ohyunsik-cmd/BMS/BMS_extra_file/발표 자료/미팅발표자료_2.19_BMS.pptx

## 2월 19일 BMS 발표

이준영, 이한준, 오윤식

## PCB 레이아웃

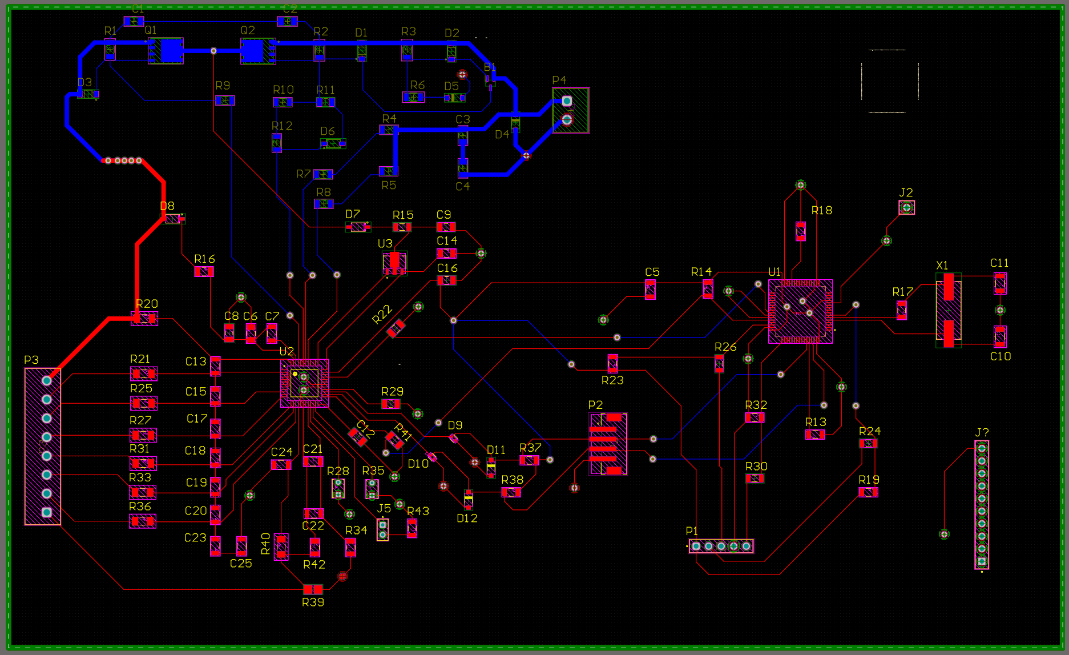
[picture p63: figure]

## PCB 레이아웃(1)

대전류가 흐르는 부분은 PCB의 뒷면에 배치하였음.

대전류가 흐르는 부분은 wire의 두께를 두껍게 설정(=40mil)

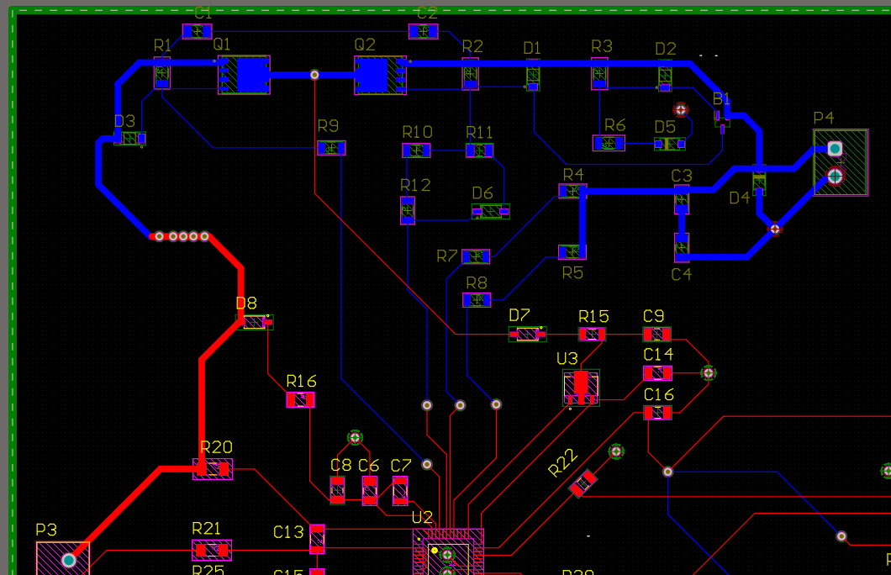
[picture p64: figure]

PGND는 layer 3층에 Net설정으로 지정하였음.

## PCB 레이아웃(2)

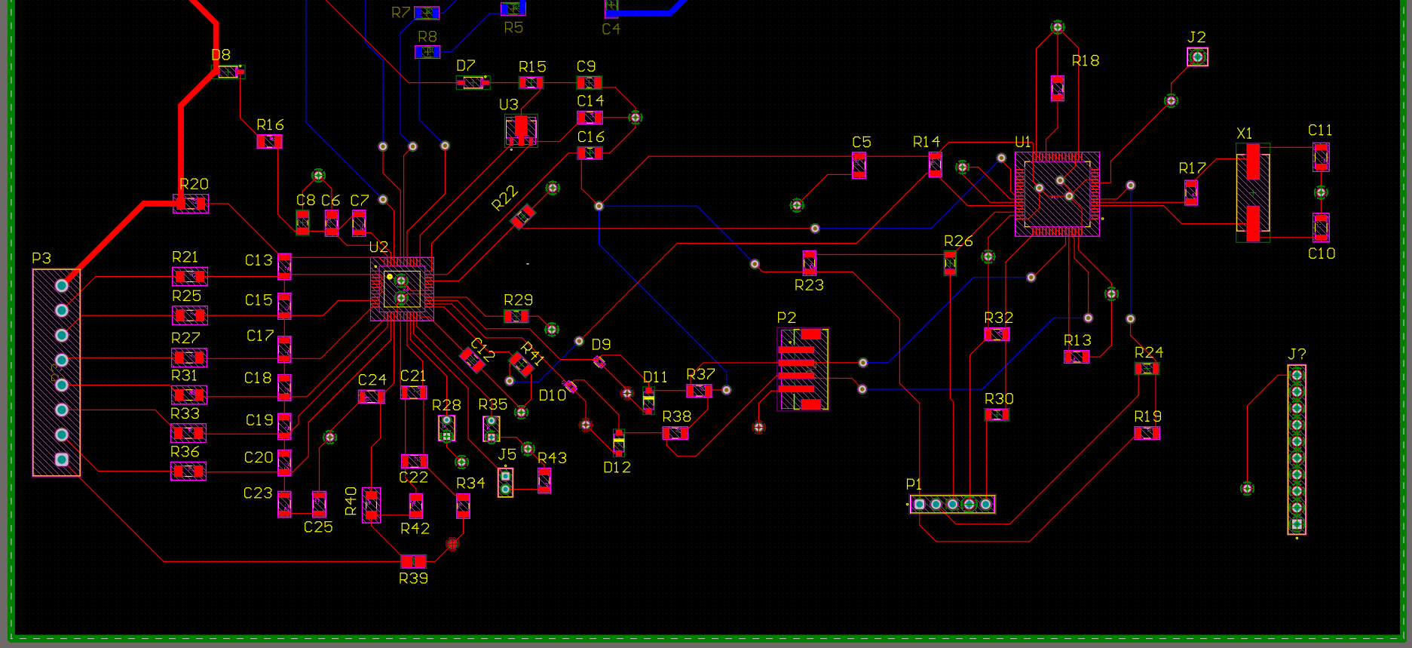
[picture p65: figure]

MCU 부분 배치

IC 부분 배치

## 원래 회로에서 소자 변경된 점

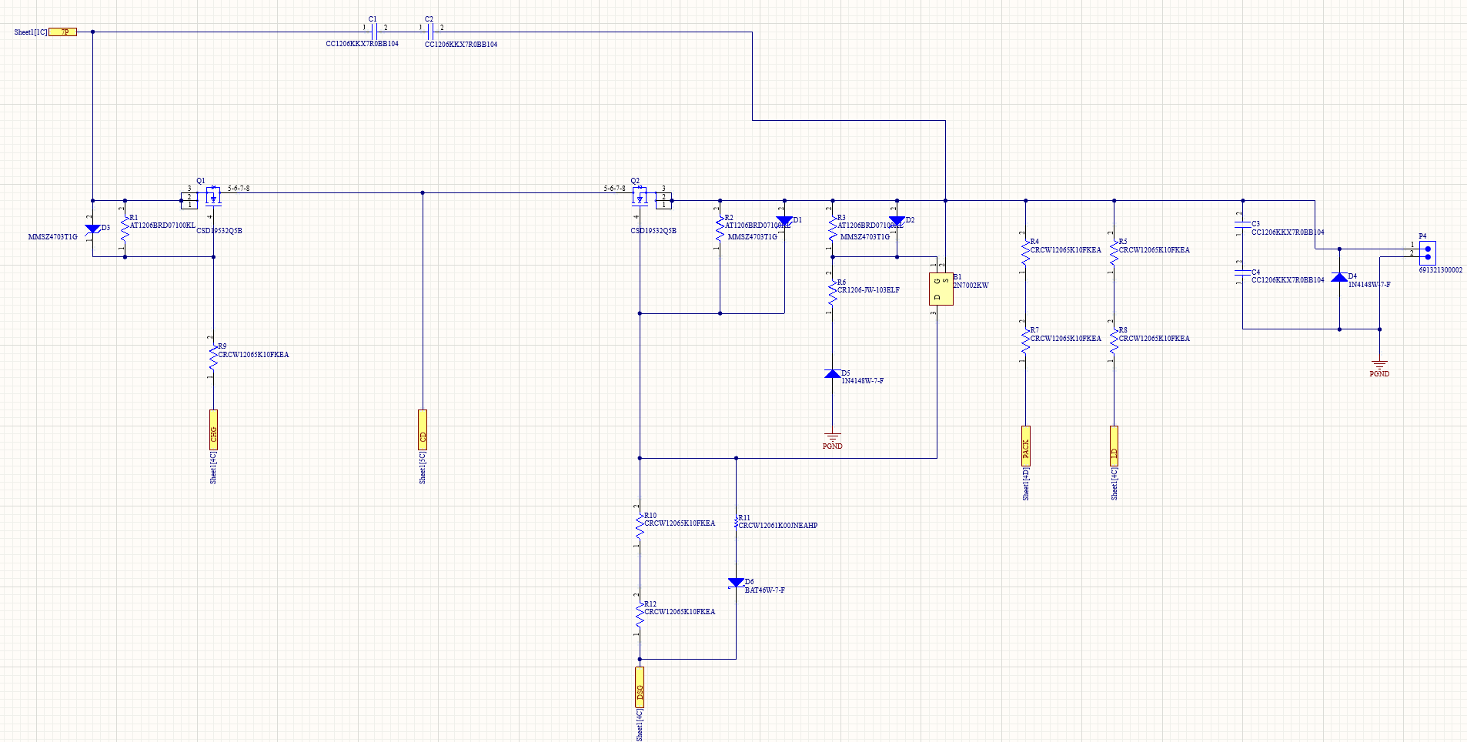
[picture p66: figure]

원래 데이터시트는
MMSZ5246B-7-F를 사용
구글링 해도 나오지 않음.
MMSZ4703T1G으로 회로 구성

## 소자 비교

MMSZ4703T1G

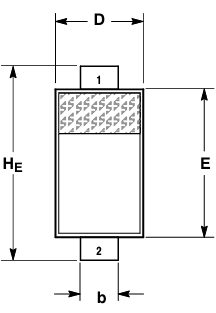
[picture p67: figure]

MMSZ5246B-7-F

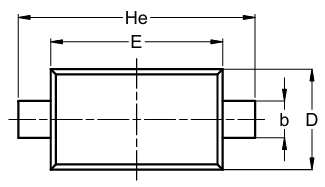
[picture p68: figure]

우측 소자의 footprint 및 symbol을 찾을 수 없어서 크기가 같고 성능이 동일한 소자를 찾아서 schematic에 추가

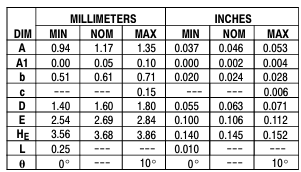
[picture p69: figure]
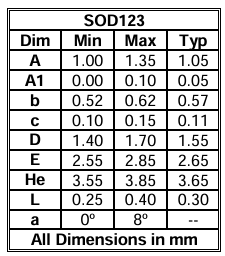
[picture p70: figure]

## 소자 주문

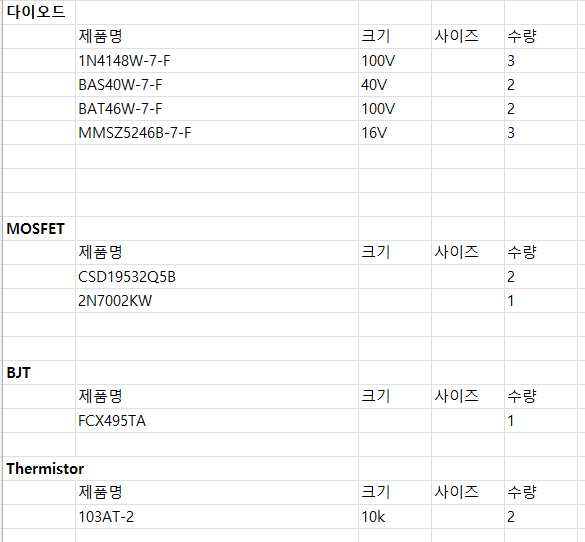
[picture p71: figure]
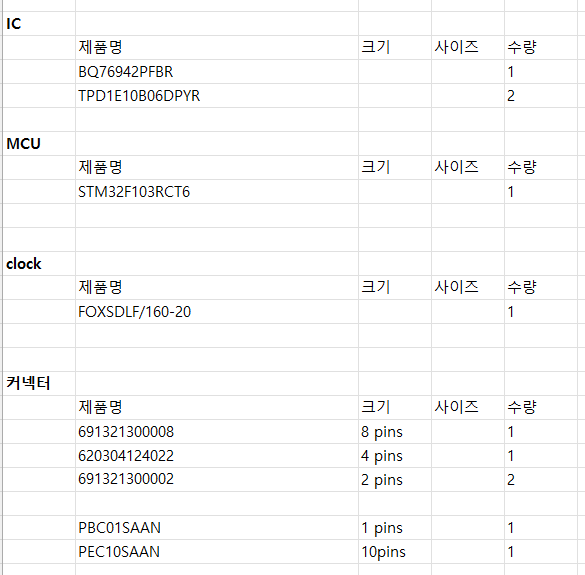
[picture p72: figure]

## 추후 계획

- PCB 주문은 완료한 상태 -> PCB 받으면 일단 납땜해서 완료
- 통신 부분은 조금 더 공부해보고 같이 진행하는 방향
