ohyunsik-cmd/BMS/BMS_extra_file/4cellbms.pptx

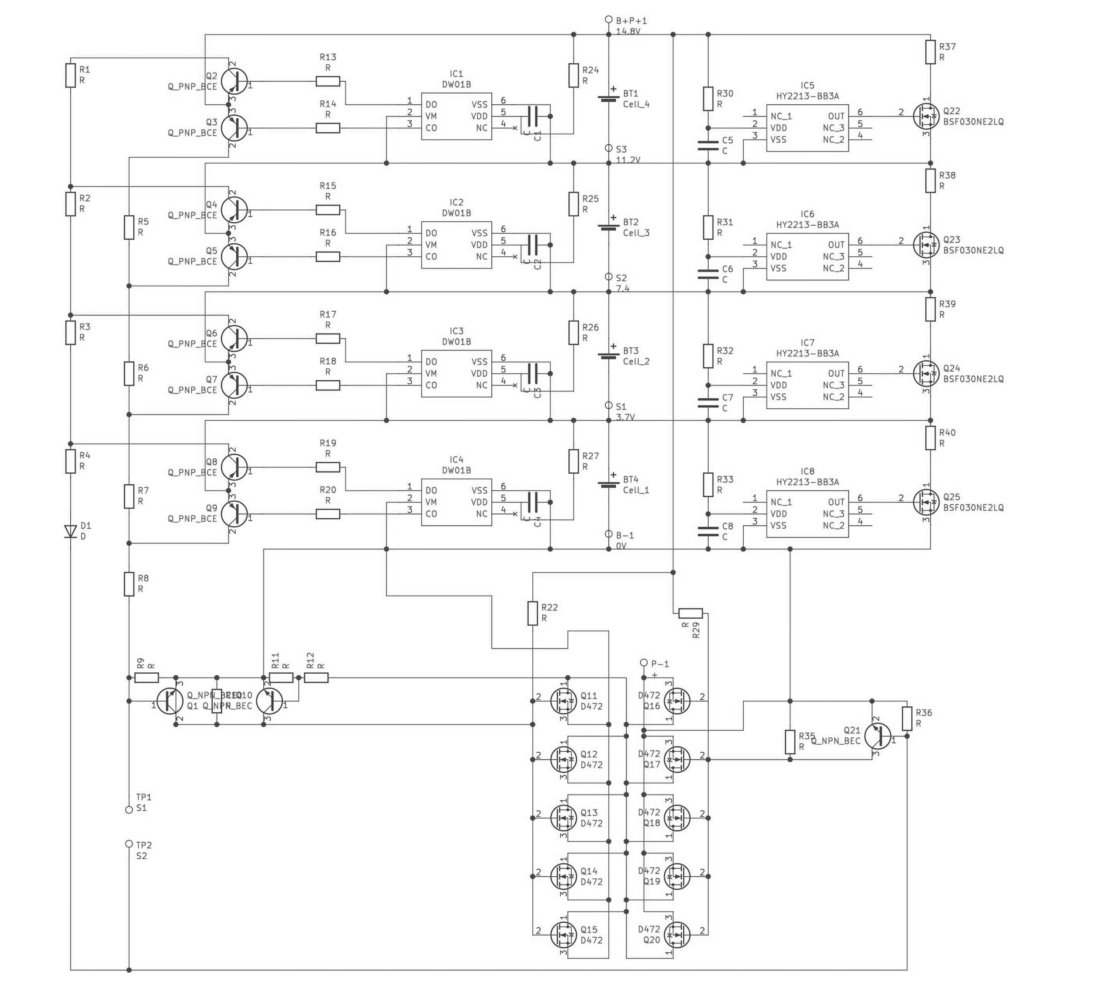
[picture p103: figure]
