ohyunsik-cmd/BMS/BMS_extra_file/10cell battery.JPG

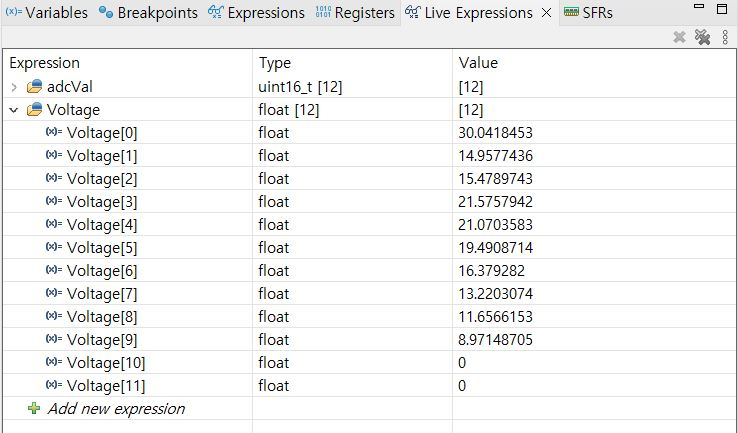
BMS_extra_file/10cell battery.JPG
