ohyunsik-cmd/BMS/(list of files, drawings)

Other design files:
BMS_Altium_file/BQ76942_2Layer_TestBoard_Altium/PR2387.PrjPcb
BMS_Altium_file/BQ76942_2Layer_TestBoard_Altium/PR2387_FETs.SchDoc
BMS_Altium_file/BQ76942_2Layer_TestBoard_Altium/PR2387_Hardware.SchDoc
BMS_Altium_file/BQ76942_2Layer_TestBoard_Altium/PR2387_Monitor.SchDoc
BMS_Altium_file/BQ76942EVM_Altium/BMS028B.PrjPcb
BMS_Altium_file/BQ76942EVM_Altium/BMS028B_FETs.SchDoc
BMS_Altium_file/BQ76942EVM_Altium/BMS028B_Hardware.SchDoc
BMS_Altium_file/BQ76942EVM_Altium/BMS028B_Interface.SchDoc
BMS_Altium_file/BQ76942EVM_Altium/BMS028B_Monitor.SchDoc
BMS_Altium_file/BQ76942EVM_Altium/BMS028B_PinConfig.SchDoc
BMS_Altium_file/PCB_Project_3/PCB_Project_3.PrjPcb
BMS_Altium_file/PCB_Project_3/Sheet1.SchDoc
BMS_Altium_file/PCB_Project_3/Sheet3.SchDoc
BMS_extra_file/stm32.mini.8.30/PCB2.PcbDoc
BMS_extra_file/stm32.mini.8.30/Sheet2.SchDoc
BMS_extra_file/stm32.mini.8.30/stm32.mini.PrjPcb
