ohyunsik-cmd/BMS/BMS_STM_file/BMS/BMS.ioc

Mcu.UserName=STM32H723ZGTx
PA10.Signal=USB_OTG_HS_ID
PA11.Signal=USB_OTG_HS_DM
PA12.Signal=USB_OTG_HS_DP
PA13(JTMS/SWDIO).GPIO_Label=SWDIO
PA13(JTMS/SWDIO).Signal=DEBUG_JTMS-SWDIO
PA14(JTCK/SWCLK).GPIO_Label=SWCLK
PA14(JTCK/SWCLK).Signal=DEBUG_JTCK-SWCLK
PA9.Signal=USB_OTG_HS_VBUS
PB0.Signal=GPIO_Output
PB14.Signal=GPIO_Output
PB8.Signal=I2C1_SCL
PB9.Signal=I2C1_SDA
PC10.Signal=GPIO_Output
PC11.Signal=GPIO_Output
PC12.Signal=GPIO_Output
PC13.Signal=GPIO_Input
PC14-OSC32_IN.Signal=RCC_OSC32_IN
PC15-OSC32_OUT.Signal=RCC_OSC32_OUT
PD8.Signal=USART3_TX
PD9.Signal=USART3_RX
PE1.Signal=GPIO_Output
