ohyunsik-cmd/BMS/(commit log)

2025-06-22 Create BMS_GUI
2025-06-22 Add BMS_GUI folder and its web project
2025-06-22 upload extra file for BMS
    [PCB2.GBL, PCB2.GBO, PCB2.GBP, PCB2.GBS, PCB2.GTL, PCB2.GTO, PCB2.GTP, PCB2.GTS]
2025-06-22 upload BMS Altium file
    [BMS028B.PrjPcb, BMS028B_FETs.SchDoc, BMS028B_Hardware.SchDoc, BMS028B_Interface.SchDoc, BMS028B_Monitor.SchDoc, BMS028B_PinConfig.SchDoc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]
