ohyunsik-cmd/BMS/(notices)

Notices in the files:
BMS_STM_file/BMS/Core/Src/main.c:
Copyright (c) 2025 STMicroelectronics.
All rights reserved.
This software is licensed under terms that can be found in the LICENSE file
